whoim2/rctester/scheme.png

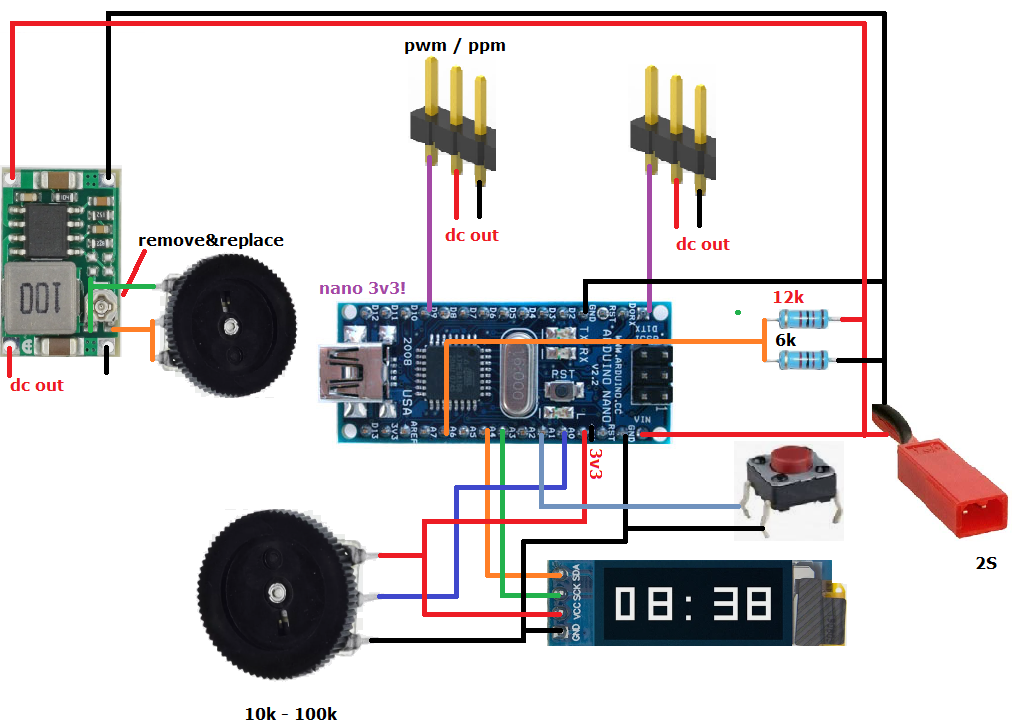
scheme.png
